arwidcool/INA219/Images/Bottom  2D_INA219 V1.0_2024-08-11.png

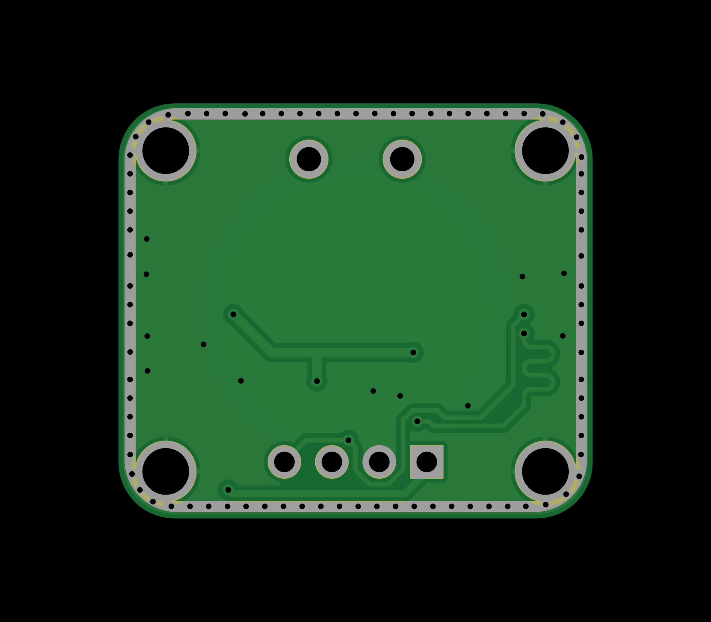
Images/Bottom 2D_INA219 V1.0_2024-08-11.png
