arwidcool/INA219/Images/Bottom PCB.JPG

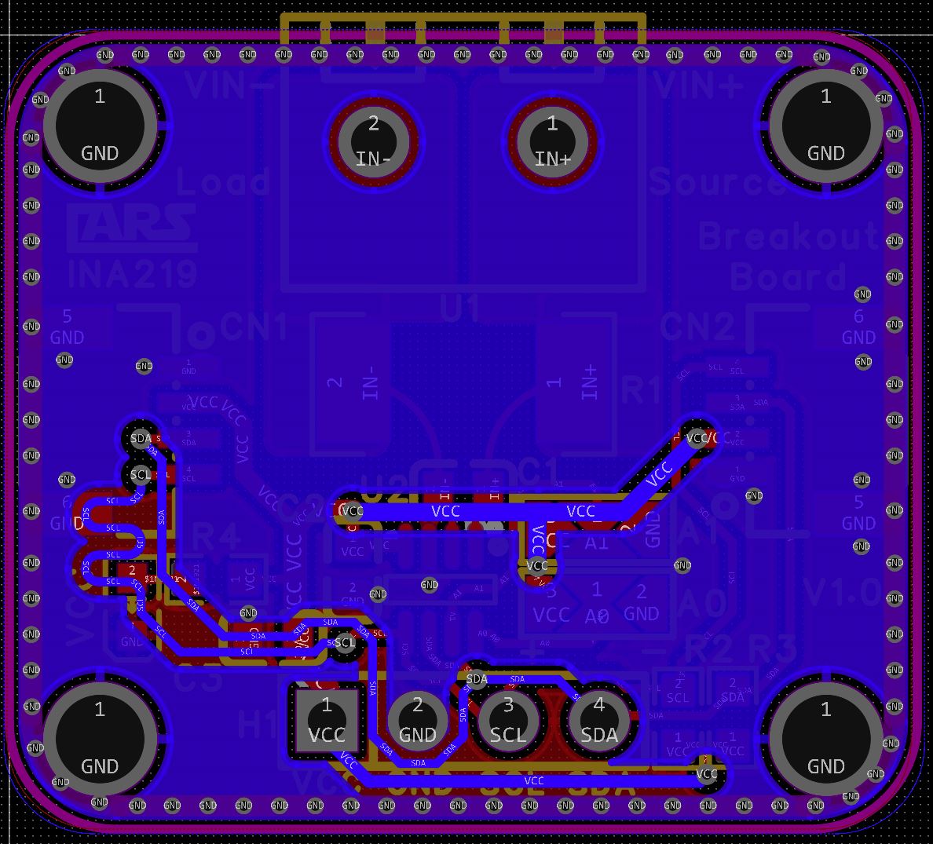
Images/Bottom PCB.JPG
