arwidcool/INA219/Images/TOP PCB.JPG

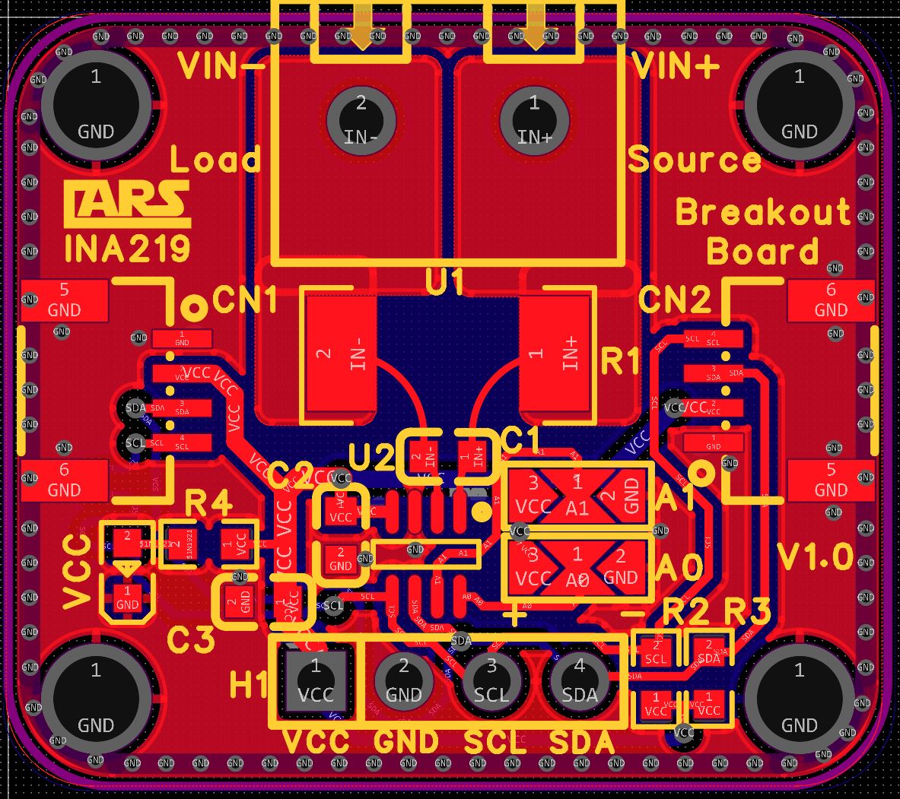
Images/TOP PCB.JPG
