arwidcool/INA219/Schematic/SCH_INA219 V1.0_2024-08-11.jpg

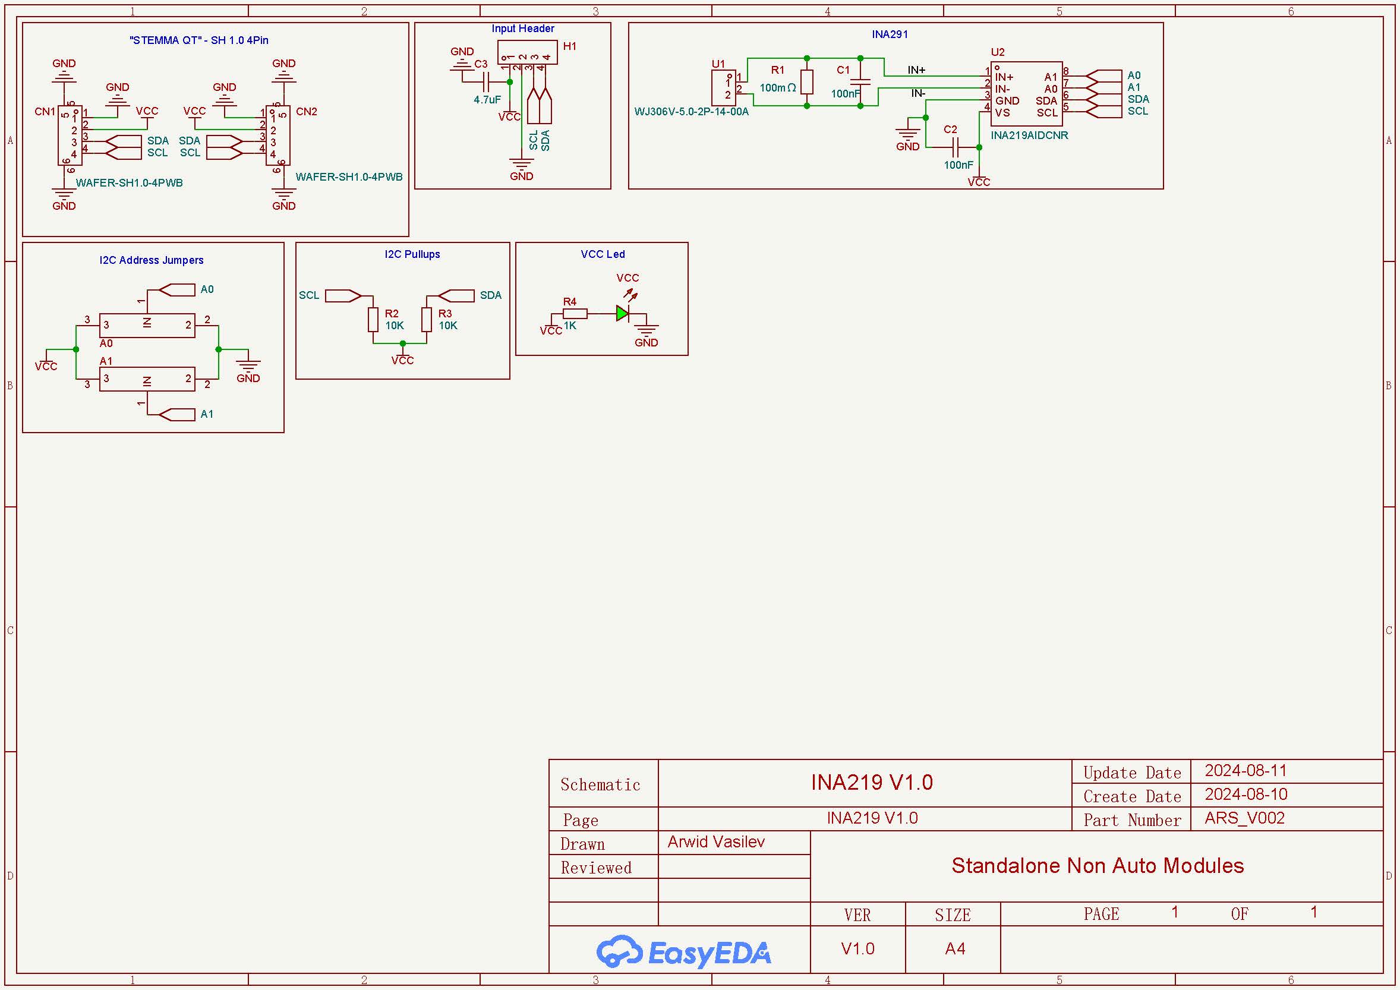
Schematic/SCH_INA219 V1.0_2024-08-11.jpg
