arwidcool/INA219/BOM/BOM_INA219 V1.0_INA219 V1.0_2024-08-11.xlsx

No. | Quantity | Comment | Designator | Footprint | Value | Manufacturer Part | Manufacturer | Supplier Part | Supplier | Pins | Supplier Footprint | Rated Voltage | Device | LCSC Price
1 | 2 | 3 Way Solder Jumper | A0,A1 | 3 way solder Jumper |  |  |  |  |  | 3 |  |  | 3 Way Solder Jumper
2 | 2 | 100nF | C1,C2 | C0603 | 100nF | TCC0603X7R104K500CT | CCTC(三环) | C282519 | LCSC | 2 | 0603 |  | TCC0603X7R104K500CT | 0.0020
3 | 1 | 4.7uF | C3 | C0603 | 4.7uF | CL10A475KP8NNNC | SAMSUNG(三星) | C1705 | LCSC | 2 | 0603 |  | CL10A475KP8NNNC
4 | 2 | WAFER-SH1.0-4PWB | CN1,CN2 | CONN-SMD_4P-P1.00_WAFER-SH1.0-4PWB |  | WAFER-SH1.0-4PWB | XUNPU(讯普) | C3029343 | LCSC | 6 | SMD,P=1mm,卧贴 |  | WAFER-SH1.0-4PWB | 0.0775
5 | 1 | HDR-M_2.54_1x4P | H1 | HDR-TH_4P-P2.54-V-M |  |  |  |  |  | 4 | Through |  | HDR-M_2.54_1x4P
6 | 1 | 100mΩ | R1 | RES-SMD_L6.4-W3.2-R2512 | 100mΩ | HoJLR2512-3W-100mR-1% | Milliohm(毫欧) | C2903476 | LCSC | 2 | 2512 |  | HoJLR2512-3W-100mR-1% | 0.0936
7 | 2 | 10kΩ | R2,R3 | R0603 | 10kΩ | SCR0603J10K | VO(翔胜) | C3017715 | LCSC | 2 | 0603 |  | SCR0603J10K | 0.0008
8 | 1 | 1kΩ | R4 | R0603 | 1kΩ | SCR0603F1K | VO(翔胜) | C3016283 | LCSC | 2 | 0603 |  | SCR0603F1K | 0.0009
9 | 1 | WJ306V-5.0-2P-14-00A | U1 | CONN-TH_2P-P5.00_L7.6-W10.0 |  | WJ306V-5.0-2P-14-00A | KANGNEX(康奈克斯电气) | C3031443 | LCSC | 2 | P=5mm |  | WJ306V-5.0-2P-14-00A | 0.0550
10 | 1 | INA219AIDCNR | U2 | SOT-23-8_L3.0-W1.7-P0.65-LS2.8-BR |  | INA219AIDCNR | TI(德州仪器) | C87469 | LCSC | 8 | SOT-23-8 |  | INA219AIDCNR | 0.7130
11 | 1 | YLED0603YG | VCC | LED0603-RD_GREEN |  | YLED0603YG | YONGYUTAI(永裕泰) | C19171392 | LCSC | 2 | 0603 |  | YLED0603YG | 0.0051
