arwidcool/INA219/Schematic/SCH_INA219 V1.0_2024-08-11.pdf

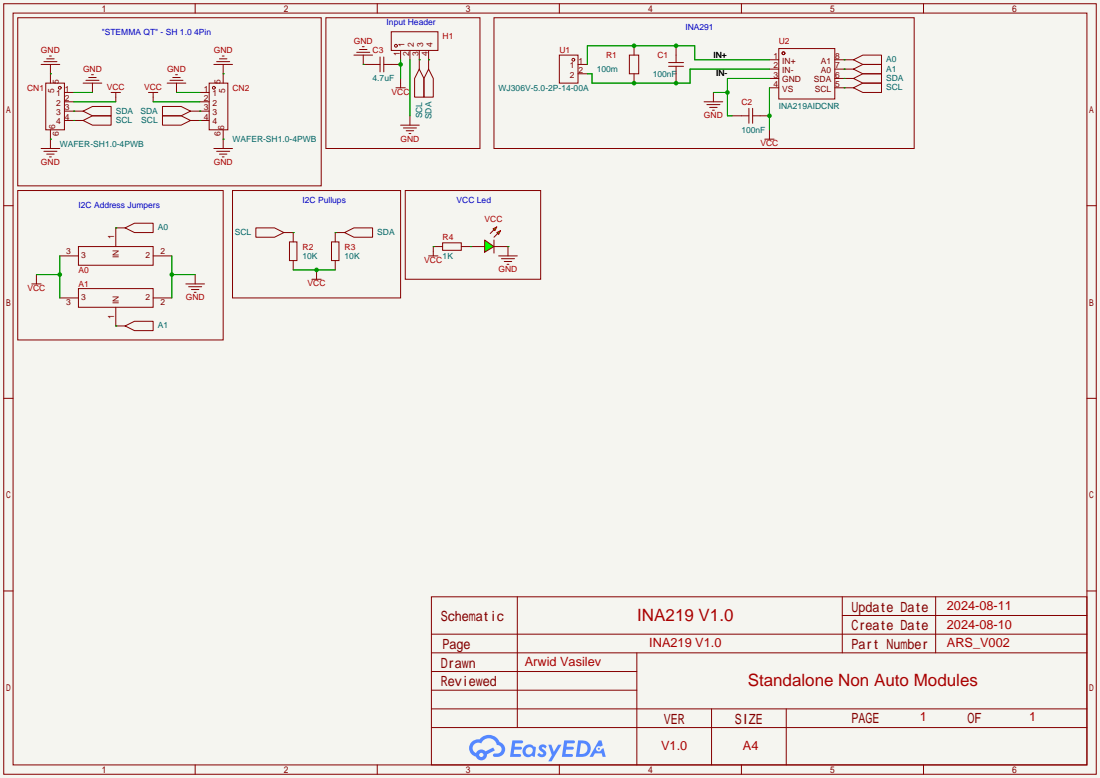
[picture p8: page 1]

Standalone Non Auto Modules
