arwidcool/INA219/(list of files, drawings)

Other design files:
EasyEDA Pro/ProProject_Standalone Non Auto Modules_2024-08-11.epro
